avnguyen08/SSS_Motherboard/docs/3D-Model-7-11-25.pdf

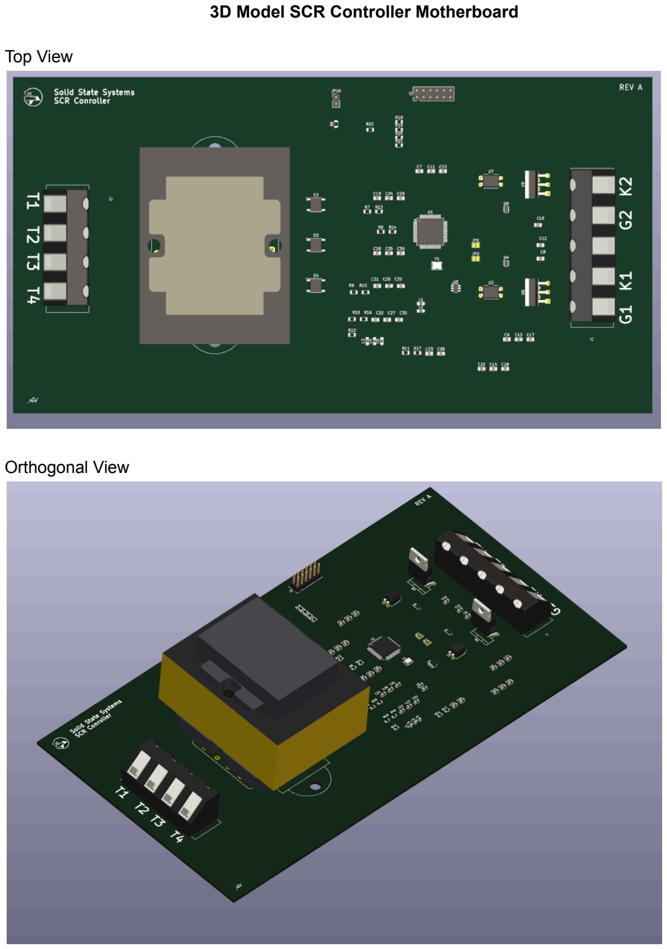
[picture p2: page 1]

3D Model SCR Controller Motherboard

Top View

Orthogonal View
