avnguyen08/SSS_Motherboard/hardware/SSS_Motherboard/MAX6817EUT_T.step

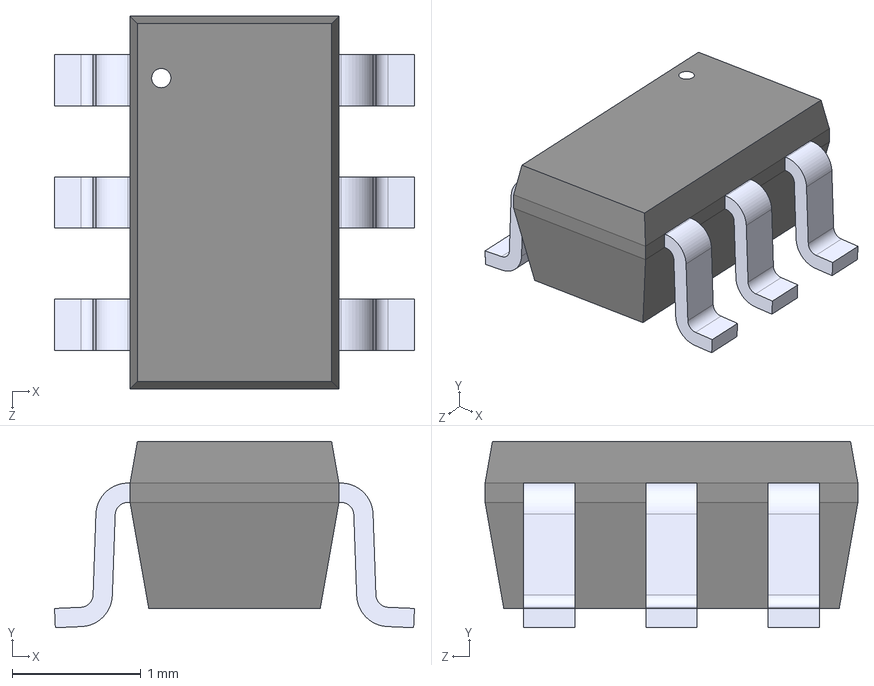
[picture p3: CAD file, 2025-07-15]
hardware/SSS_Motherboard/MAX6817EUT_T.step
2.80 x 1.45 x 2.90 mm
