avnguyen08/SSS_Motherboard/docs/Block_Diagram_6-Channel_SCR_PWM-5-21-25.pdf

6-Channel SCR Controller (PWM) | Date: 5/8/2025

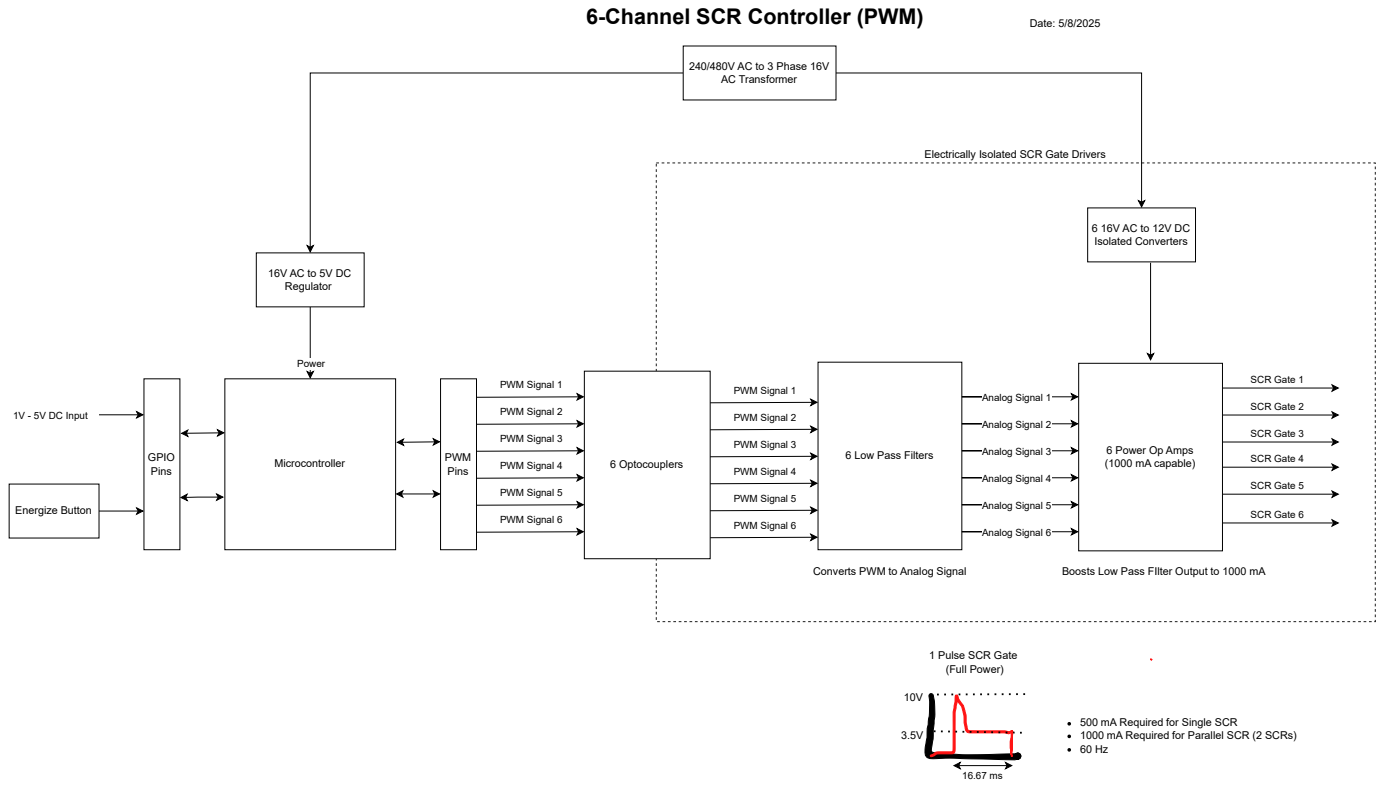
[picture p4: page 1]
Microcontroller; SCR Gate 1; SCR Gate 2; SCR Gate 3; SCR Gate 4; SCR Gate 5; SCR Gate 6; GPIO Pins; PWM Signal 1; 6 Optocouplers; Power; Energize Button; 1V - 5V DC Input; Analog Signal 1; Analog Signal 2; Analog Signal 3; Analog Signal 4; Analog Signal 5; Analog Signal 6; Converts PWM to Analog Signal; Boosts Low Pass FIlter Output to 1000 mA; PWM Pins; PWM Signal 2; PWM Signal 3; PWM Signal 4; PWM Signal 5; PWM Signal 6

240/480V AC to 3 Phase 16V
AC Transformer

Electrically Isolated SCR Gate Drivers

Isolated Converters

Regulator

6 Power Op Amps
(1000 mA capable)

6 Low Pass Filters

1 Pulse SCR Gate
(Full Power)

500 mA Required for Single SCR
1000 mA Required for Parallel SCR (2 SCRs)
