avnguyen08/SSS_Motherboard/docs/Schematic-7-11-25.pdf

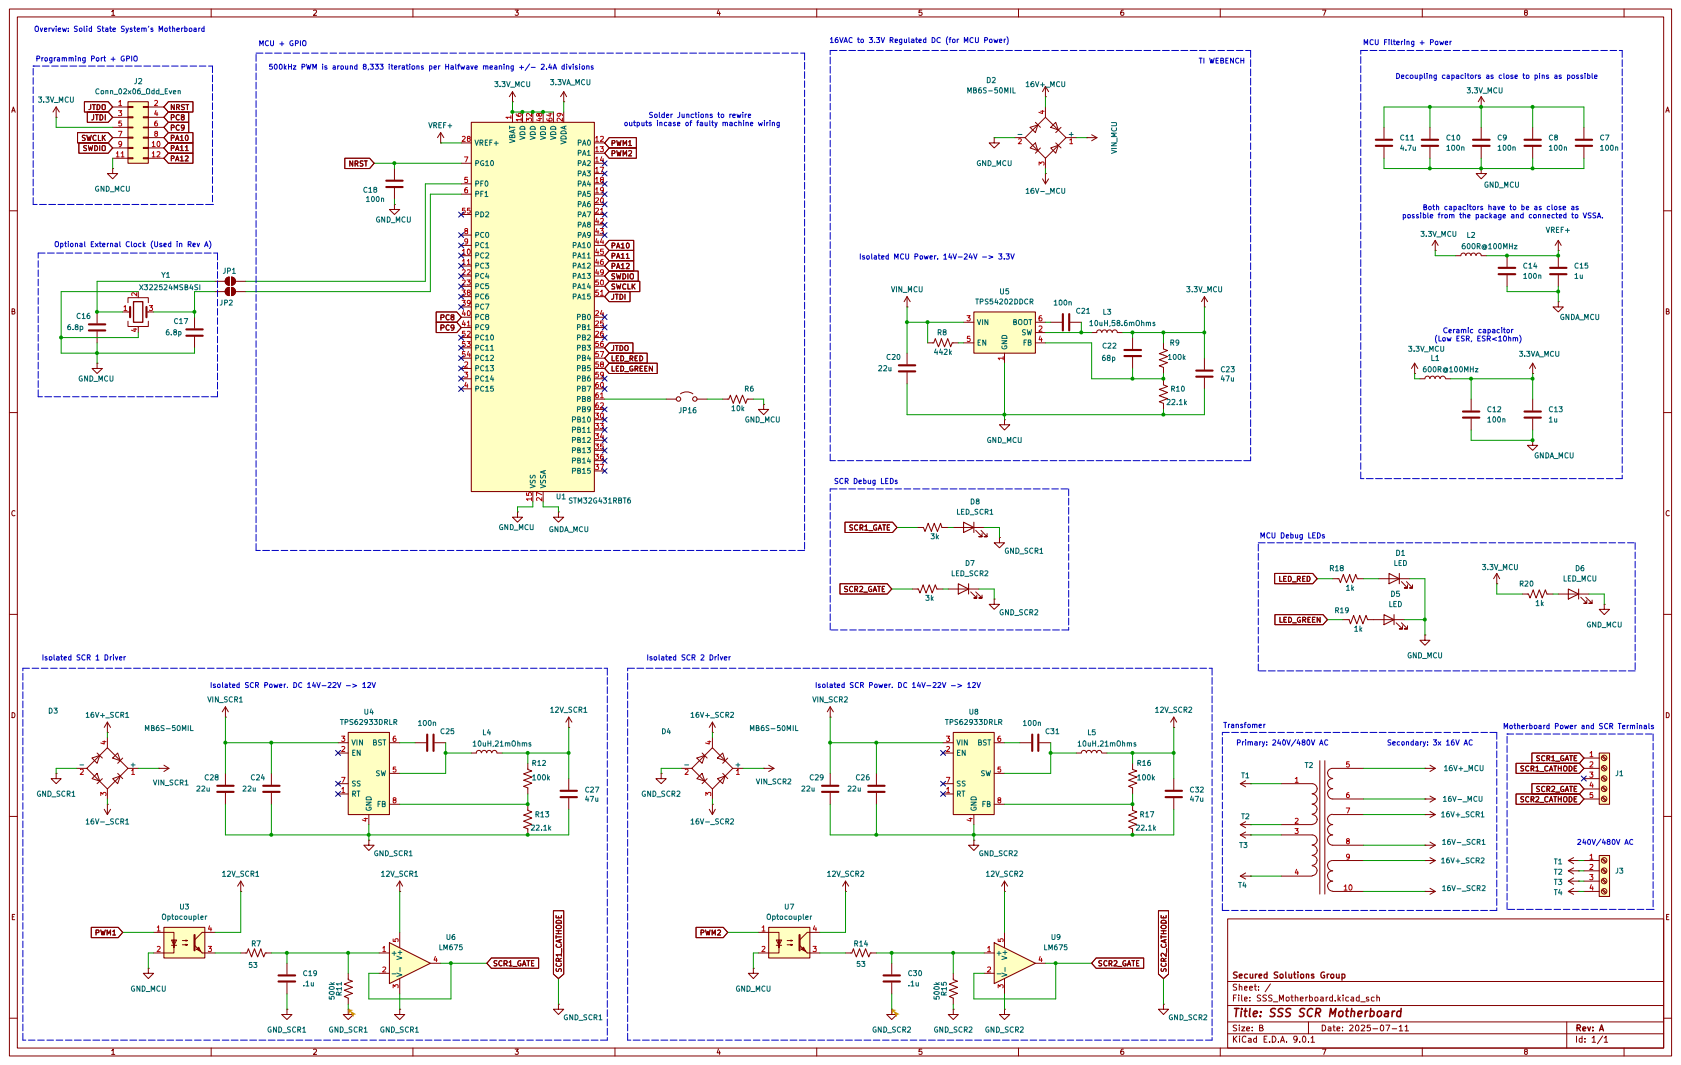
[picture p5: page 1]
