avnguyen08/SSS_Motherboard/hardware/Draft2.asc

C1: cap; .1µ
R1: res; 5
R2: res; 1Mega
R3: res; 1k
R4: res; 53
R5: res; 500k
U1: PC817A
V1: voltage; PULSE(0 3 0 10p 10p 1u 2u 20)
V2: voltage; 12; Rser=3m
Named nets: PWM, 0, COM, 12V, Vout, Filtered_PWM
.tran 50u
