avnguyen08/SSS_Motherboard/hardware/Draft3.asc

C1: cap; .01µ
R1: res; 5
R2: res; 1Mega
R3: res; 1k
R4: res; 500
R5: res; 500
U1: PC817A
U2: UniversalOpAmp
V1: voltage; PULSE(0 3 0 10n 10n 5u 10u 20)
V2: voltage; 12; Rser=3m
Named nets: PWM, 0, COM, 12V, Vout, Filtered_PWM
.tran 50u
