avnguyen08/SSS_Motherboard/hardware/Draft5.asc

R1: res; 1Mega
U2: UniversalOpAmp
V1: voltage; 12; Rser=3m
V2: voltage; SINE(2 1 100k)
Named nets: 12V, 0, COM
.tran 50u
