avnguyen08/SSS_Motherboard/hardware/PWM_Filter.asc

C1: cap; .1µ
Q1: npn; 2N2222
R1: res; 1k
R2: res; 50
R3: res; 100
R4: res; 1Mega
R5: res; 1k
R6: res; 53
U1: opamp
U2: PC817A
V1: voltage; PULSE(0 3 0 10p 10p 10u 20u 20)
V2: voltage; 12; Rser=3m
Named nets: PWM, 0, 12V, COM, Vout, INV_Vout, Filtered_PWM
.tran 500u
