avnguyen08/SSS_Motherboard/hardware/SCRSimulation.asc

R1: res; 100
U1: SCR; TN6050HP-12
V1: voltage; 20
V2: voltage; SINE(0 200 60)
Named nets: Wave, 0
.tran .1
.inc C:\\Users\\aaron\\OneDrive\\Documents\\LTspiceXVII\\lib\\sym\\st_high-temperature_scr_pspice\\st_high-temperature_scr.lib
