avnguyen08/SSS_Motherboard/hardware/Blue_Module.asc

C1: cap; 220µ
C2: cap; 4.7µ
D1: diode
D2: diode
D3: diode
D4: diode
D5: diode
D6: LED
D7: diode
Q1: npn
Q2: npn
Q3: npn
R1: res; 2.2
R2: res; 2.2
R3: res; 1k
R4: res; 100
R5: res; 40
R6: res; 470
R7: res; 4.7k
R8: res; 4.7k
R9: res; 4.7k
R10: res; 4.7k
R11: res; 4.7k
R12: res; 4.7k
R13: res; 100Mega
R14: res; 300
U1: PC817A
V1: voltage; SINE(0 16 60 0 0 0 10)
V2: voltage; PULSE(0 4 0 .0001 .0001 .008 .01666 10)
Named nets: 11, 10, 12, 14, 0, Input, Out, COM, before_input
.tran .6s
Blue Module (Input pulse converted into output across SCRs gate and cathode)
