avnguyen08/SSS_Motherboard/hardware/Draft4.asc

A1: and
A2: and
A3: and
A4: and
C1: cap
C2: cap
C3: cap
C4: cap
C5: cap
C6: cap
C7: cap
D1: diode
D2: diode
D3: diode
D4: diode
D5: diode
POT1: res
POT2: res
POT3: res
POT4: res
R1: res
R2: res
R3: res
R4: res
R5: res
R6: res
R7: res
R8: res
R9: res
R10: res
R11: res
R12: res
R13: res
R14: res
R15: res
R16: res
R17: res
R18: res
R19: res
R20: res
R21: res
R22: res
U1: opamp
U2: opamp
U3: opamp
U4: opamp
V1: voltage; SINE(0 14 60)
Named nets: 0, +, 10, 13, 2
.tran 100m
.inc opamp.sub
