avnguyen08/SSS_Motherboard/hardware/SSS_Motherboard/SSS_Motherboard.kicad_pcb

## KiCad design hardware/SSS_Motherboard/SSS_Motherboard.kicad_pcb (2025-09-15)

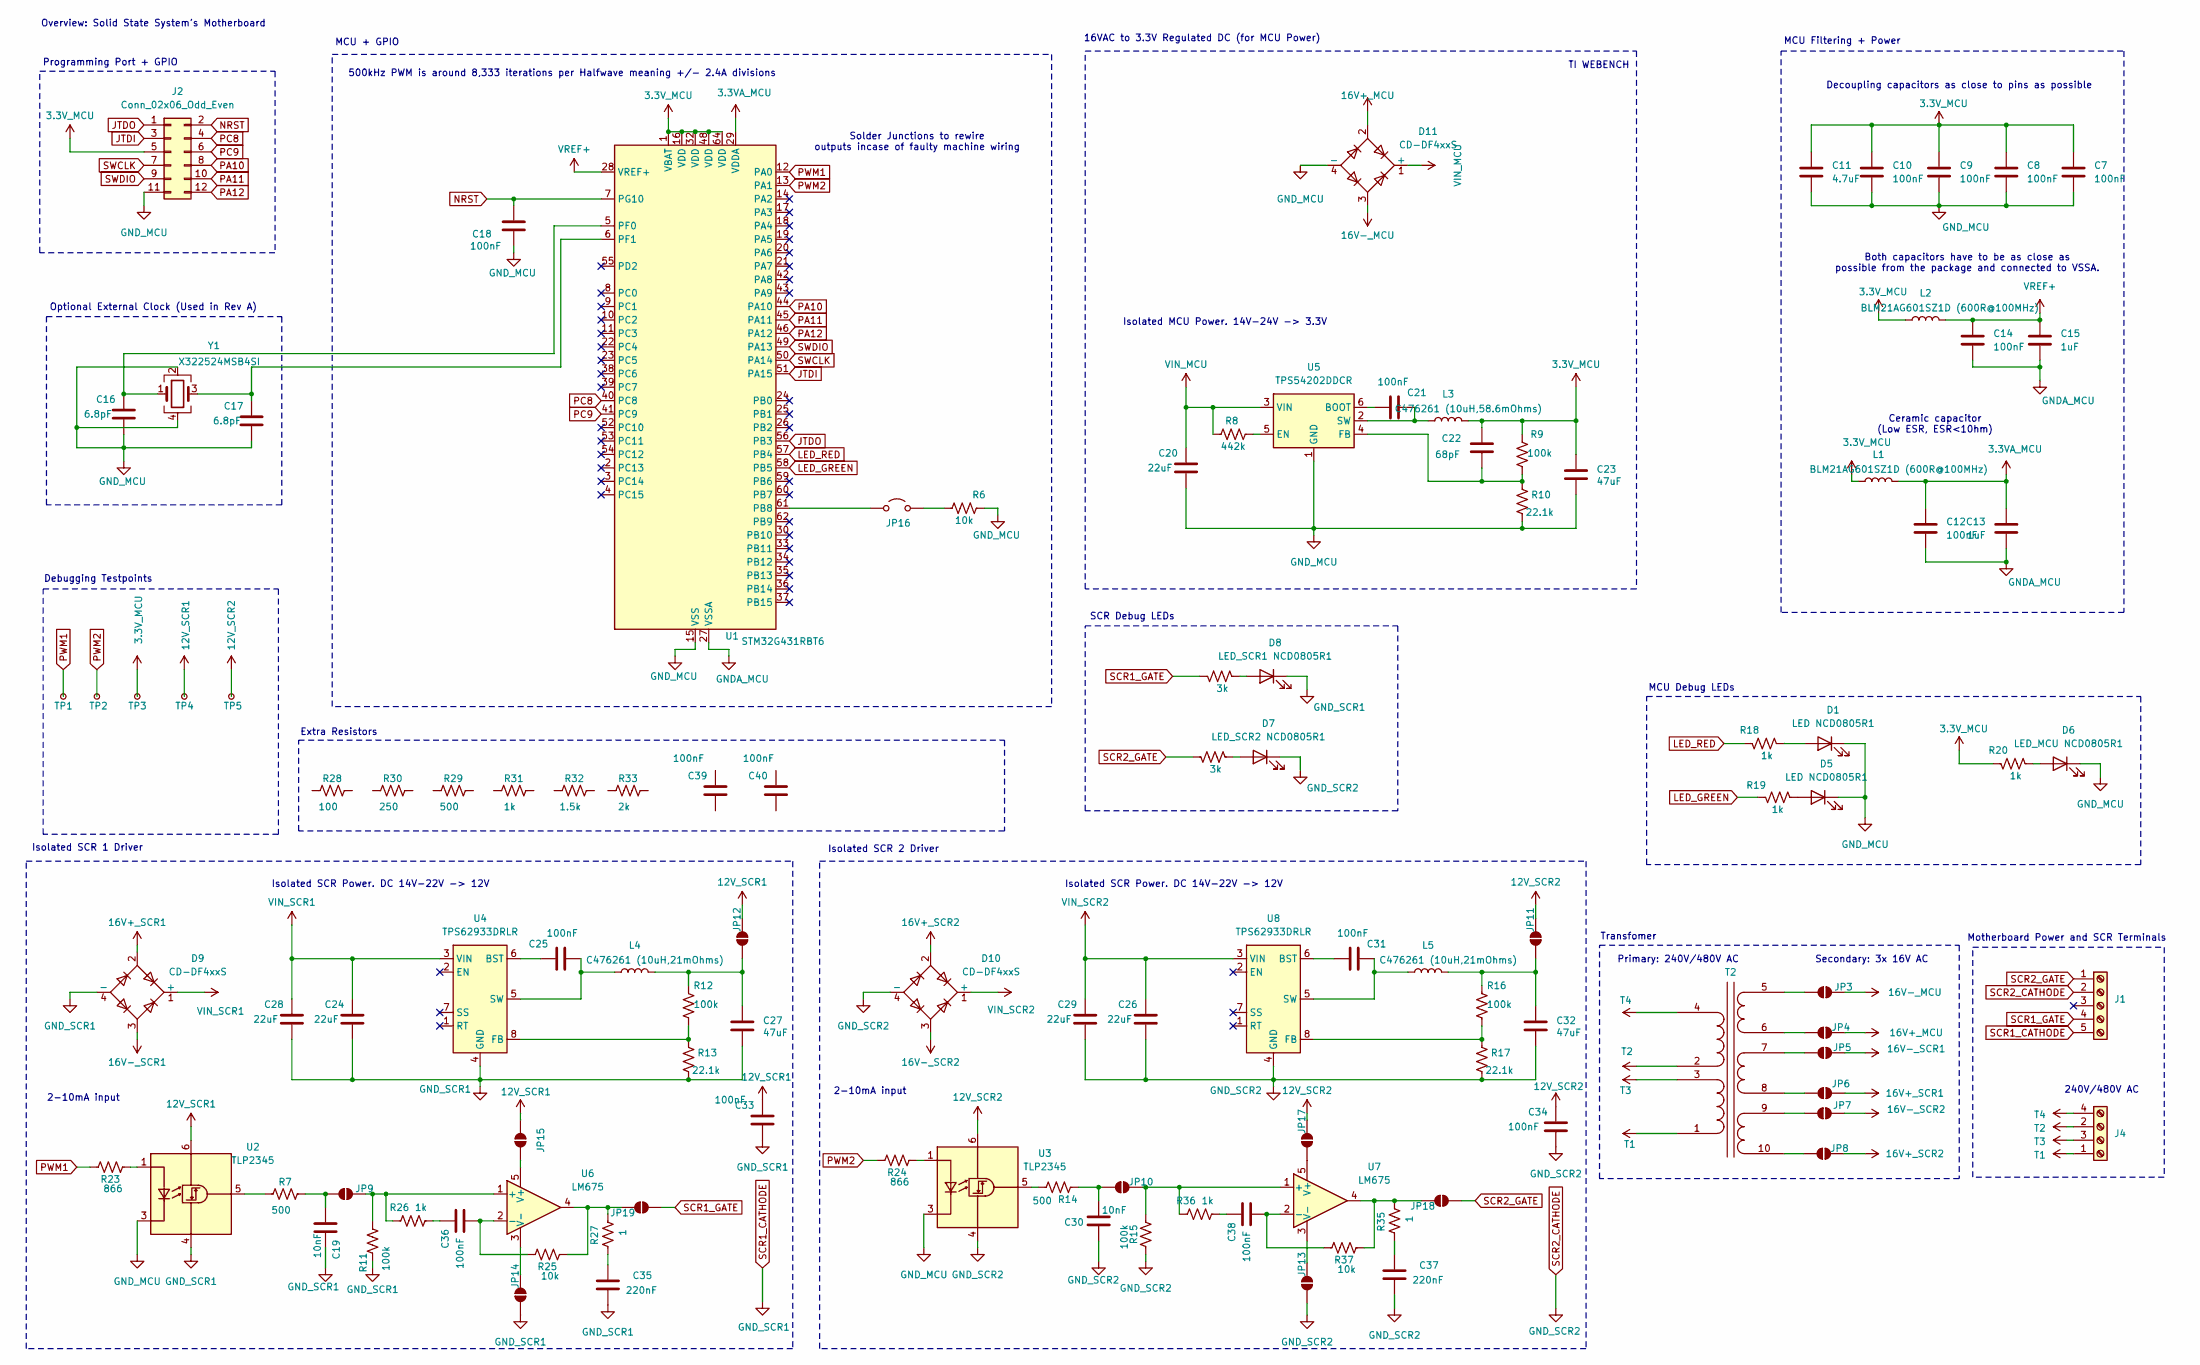
[picture p6: schematic SSS_Motherboard.kicad_sch, SSS SCR Motherboard]

Parts:
C7, C8, C9, C10, C12, C14, C18, C21, C25, C31, C33, C34, C36, C38, C39, C40: 100nF; C_0805_2012Metric
C11: 4.7uF; C_0805_2012Metric
C13, C15: 1uF; C_0805_2012Metric
C16, C17: 6.8pF; C_0805_2012Metric
C19, C30: 10nF; C_0805_2012Metric
C20, C24, C26, C28, C29: 22uF; C_0805_2012Metric
C22: 68pF; C_0805_2012Metric
C23, C27, C32: 47uF; C_0805_2012Metric
C35, C37: 220nF; C_0805_2012Metric
D1, D5: LED NCD0805R1; D_0805_2012Metric
D6: LED_MCU NCD0805R1; D_0805_2012Metric
D7: LED_SCR2 NCD0805R1; D_0805_2012Metric
D8: LED_SCR1 NCD0805R1; D_0805_2012Metric
D9, D10, D11: CD-DF4xxS; CD-DF4xxS(L)
J1: Screw_Terminal_01x05; 5_Connector_11.13_Pitch
J2: Conn_02x06_Odd_Even; PinHeader_2x06_P2.54mm_Vertical
J4: Screw_Terminal_01x04; 4_Connector_11.13_Pitch
JP3, JP4, JP5, JP6, JP7, JP8, JP9, JP10, JP11, JP12, JP13, JP14, JP15, JP17, JP18, JP19: SolderJumper_2_Open; SolderJumper-2_P1.3mm_Open_Pad1.0x1.5mm
JP16: Jumper_2_Open; PinHeader_1x02_P2.54mm_Vertical
L1, L2: BLM21AG601SZ1D (600R@100MHz); L_0805_2012Metric
L3: C476261 (10uH,58.6mOhms); SRN6045
L4, L5: C476261 (10uH,21mOhms); SRN6045
R6, R25, R37: 10k; R_0805_2012Metric
R7, R14, R29: 500; R_0805_2012Metric
R8: 442k; R_0805_2012Metric
R9, R11, R12, R15, R16: 100k; R_0805_2012Metric
R10, R13, R17: 22.1k; R_0805_2012Metric
R18, R19, R20, R26, R31, R36: 1k; R_0805_2012Metric
R21, R22: 3k; R_0805_2012Metric
R23, R24: 866; R_0805_2012Metric
R27, R35: 1; R_0805_2012Metric
R28: 100; R_0805_2012Metric
R30: 250; R_0805_2012Metric
R32: 1.5k; R_0805_2012Metric
R33: 2k; R_0805_2012Metric
T2: Transformer_2P_3S; Transformer
TP1, TP2, TP3, TP4, TP5: TestPoint_Small; TestPoint_Loop_D2.50mm_Drill1.0mm
U1: STM32G431RBT6; LQFP-64_10x10mm_P0.5mm
U2, U3: TLP2345; SO-5-6_4.55x3.7mm_P1.27mm
U4, U8: TPS62933DRLR; SOT-583-8
U5: TPS54202DDCR; SOT-23-6
U6, U7: LM675; TO-220-5_P3.4x3.7mm_StaggerOdd_Lead3.8mm_Vertical
Y1: X322524MSB4SI; Crystal_SMD_3225-4Pin_3.2x2.5mm

Connections:
3.3VA_MCU: C12.1, C13.1, L1.1, U1.29 (VDDA)
3.3V_MCU: C7.1, C8.1, C9.1, C10.1, C11.1, C22.2, C23.1, J2.5, L1.2, L2.1, L3.1, R9.1, R20.1, TP3.1, U1.1 (VBAT), U1.16 (VDD), U1.32 (VDD), U1.48 (VDD), U1.64 (VDD)
12V_SCR1: C33.1, JP12.2 (B), JP15.2 (B), TP4.1, U2.6 (VDD)
12V_SCR2: C34.1, JP11.2 (B), JP17.2 (B), TP5.1, U3.6 (VDD)
16V+_MCU: D11.2, JP4.2 (B)
16V+_SCR1: D9.2, JP6.2 (B)
16V+_SCR2: D10.2, JP8.2 (B)
16V-_MCU: D11.3, JP3.2 (B)
16V-_SCR1: D9.3, JP5.2 (B)
16V-_SCR2: D10.3, JP7.2 (B)
GNDA_MCU: C12.2, C13.2, C14.2, C15.2, U1.27 (VSSA)
GND_MCU: C7.2, C8.2, C9.2, C10.2, C11.2, C16.2, C17.2, C18.1, C20.2, C23.2, D1.1 (K), D5.1 (K), D6.1 (K), D11.4 (-), J2.11, R6.1, R10.1, U1.15 (VSS), U1.31 (VSS), U1.47 (VSS), U1.63 (VSS), U2.3 (K), U3.3 (K), U5.1 (GND), Y1.2, Y1.4
JTDI: J2.3, U1.51 (PA15)
JTDO: J2.1, U1.56 (PB3)
LED_GREEN: R19.1, U1.58 (PB5)
LED_RED: R18.1, U1.57 (PB4)
NRST: C18.2, J2.2, U1.7 (PG10)
unnamed: C35.1, R27.2
unnamed: C36.1, R26.1
unnamed: C37.1, R35.2
unnamed: C38.1, R36.1
unnamed: D1.2 (A), R18.2
unnamed: D5.2 (A), R19.2
unnamed: D6.2 (A), R20.2
unnamed: D7.2 (A), R21.2
unnamed: D8.2 (A), R22.2
unnamed: JP3.1 (A), T2.5 (SA)
unnamed: JP4.1 (A), T2.6 (SB)
unnamed: JP5.1 (A), T2.7 (SC)
unnamed: JP6.1 (A), T2.8 (SD)
unnamed: JP7.1 (A), T2.9 (SC)
unnamed: JP8.1 (A), T2.10 (SD)
unnamed: C19.1, JP9.1 (A), R7.2
unnamed: JP9.2 (B), R11.2, R26.2, U6.1 (+)
unnamed: C30.1, JP10.1 (A), R14.2
unnamed: JP10.2 (B), R15.2, R36.2, U7.1 (+)
unnamed: C32.1, JP11.1 (A), L5.1, R16.1
unnamed: C27.1, JP12.1 (A), L4.1, R12.1
unnamed: JP13.2 (B), U7.3 (V-)
unnamed: JP14.2 (B), U6.3 (V-)
unnamed: JP15.1 (A), U6.5 (V+)
unnamed: JP16.1 (A), U1.61 (PB8)
unnamed: JP16.2 (B), R6.2
unnamed: JP17.1 (A), U7.5 (V+)
unnamed: JP18.2 (B), R35.1, R37.1, U7.4
unnamed: JP19.2 (B), R25.1, R27.1, U6.4
unnamed: C16.1, U1.5 (PF0), Y1.1
unnamed: C17.1, U1.6 (PF1), Y1.3
unnamed: R23.1, U2.1 (A)
unnamed: R7.1, U2.5 (VO)
unnamed: R24.1, U3.1 (A)
unnamed: R14.1, U3.5 (VO)
unnamed: C25.1, U4.6 (BST)
unnamed: R12.2, R13.2, U4.8 (FB)
unnamed: C25.2, L4.2, U4.5 (SW)
unnamed: C21.2, U5.6 (BOOT)
unnamed: R8.1, U5.5 (EN)
unnamed: C22.1, R9.2, R10.2, U5.4 (FB)
unnamed: C21.1, L3.2, U5.2 (SW)
unnamed: C36.2, R25.2, U6.2 (-)
unnamed: C38.2, R37.2, U7.2 (-)
unnamed: C31.2, U8.6 (BST)
unnamed: R16.2, R17.2, U8.8 (FB)
unnamed: C31.1, L5.2, U8.5 (SW)
PA10: J2.8, U1.44 (PA10)
PA11: J2.10, U1.45 (PA11)
PA12: J2.12, U1.46 (PA12)
PC8: J2.4, U1.40 (PC8)
PC9: J2.6, U1.41 (PC9)
PWM1: R23.2, TP1.1, U1.12 (PA0)
PWM2: R24.2, TP2.1, U1.13 (PA1)
SCR1_CATHODE: C19.2, C24.2, C27.2, C28.2, C33.2, C35.2, D8.1 (K), D9.4 (-), J1.5, JP14.1 (A), R11.1, R13.1, U2.4 (GND), U4.4 (GND)
SCR1_GATE: J1.4, JP19.1 (A), R22.1
SCR2_CATHODE: C26.2, C29.2, C30.2, C32.2, C34.2, C37.2, D7.1 (K), D10.4 (-), J1.2, JP13.1 (A), R15.1, R17.1, U3.4 (GND), U8.4 (GND)
SCR2_GATE: J1.1, JP18.1 (A), R21.1
SWCLK: J2.7, U1.50 (PA14)
SWDIO: J2.9, U1.49 (PA13)
T1: J4.1 (Pin_4), T2.1 (AA)
T2: J4.2, T2.2 (AA)
T3: J4.3, T2.3 (AB)
T4: J4.4 (Pin_1), T2.4 (AB)
VIN_MCU: C20.1, D11.1 (+), R8.2, U5.3 (VIN)
VIN_SCR1: C24.1, C28.1, D9.1 (+), U4.3 (VIN)
VIN_SCR2: C26.1, C29.1, D10.1 (+), U8.3 (VIN)
VREF+: C14.1, C15.1, L2.2, U1.28 (VREF+)

Notes on the sheet:
Secondary: 3x 16V AC
Isolated SCR Power. DC 14V-22V -> 12V
Motherboard Power and SCR Terminals
Isolated SCR 2 Driver
MCU + GPIO
Isolated SCR 1 Driver
Decoupling capacitors as close to pins as possible
Primary: 240V/480V AC
Optional External Clock (Used in Rev A)
Transfomer
SCR Debug LEDs
2-10mA input
Solder Junctions to rewire outputs incase of faulty machine wiring
Debugging Testpoints
500kHz PWM is around 8,333 iterations per Halfwave meaning +/- 2.4A divisions
MCU Filtering + Power
Isolated MCU Power. 14V-24V -> 3.3V
Both capacitors have to be as close as possible from the package and connected to VSSA.
TI WEBENCH
Ceramic capacitor (Low ESR, ESR<10hm)
Extra Resistors
Programming Port + GPIO
MCU Debug LEDs
240V/480V AC
Overview: Solid State System's Motherboard
16VAC to 3.3V Regulated DC (for MCU Power)

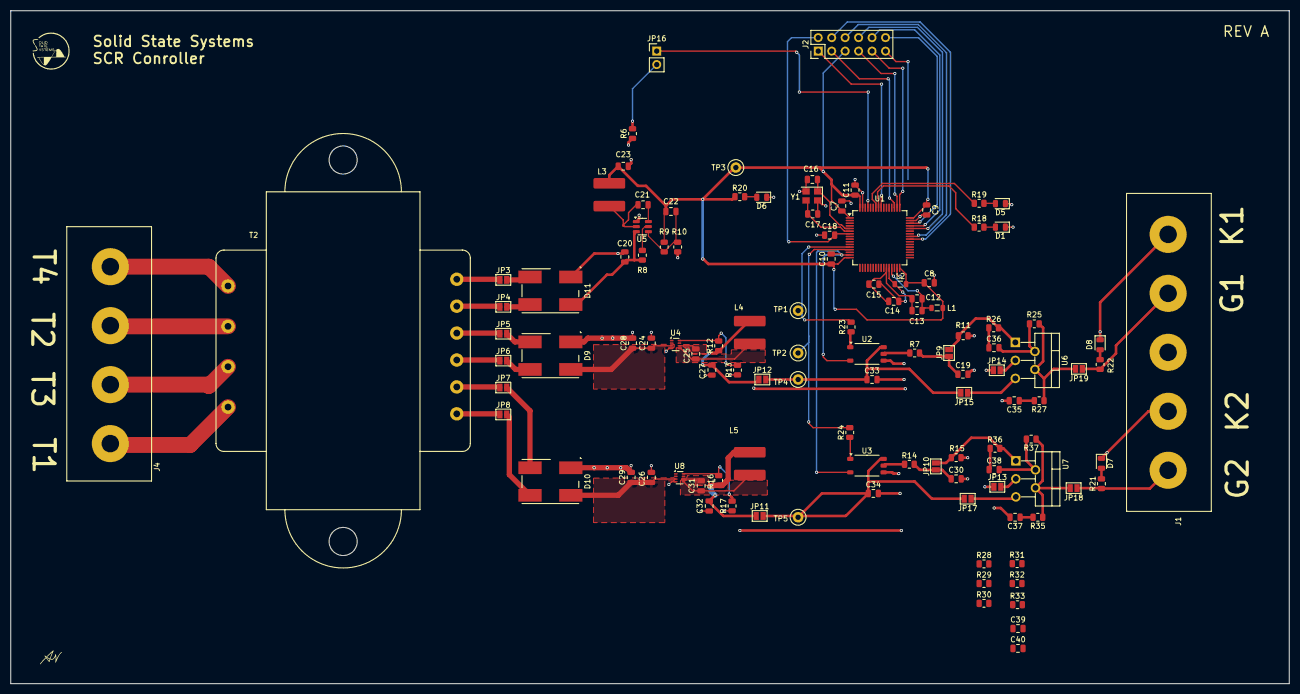
[picture p7: board SSS_Motherboard.kicad_pcb from above]

Board: 2 copper layers, 241.3 x 127.0 mm, 113 parts (0 on the bottom side), 85 nets.
