avnguyen08/SSS_Motherboard/software/workspace_1.18.1/SSS_Motherboard/SSS_Motherboard.ioc

Mcu.UserName=STM32G431RBTx
PA0.Signal=S_TIM2_CH1
PA1.Signal=S_TIM2_CH2
PB4.GPIO_Label=LED_RED
PB4.Signal=GPIO_Output
PB5.GPIO_Label=LED_GREEN
PB5.Signal=GPIO_Output
PF0-OSC_IN.Signal=RCC_OSC_IN
PF1-OSC_OUT.Signal=RCC_OSC_OUT
