avnguyen08/SSS_Motherboard/software/workspace_1.18.1/SSS_Motherboard/Core/Inc/main.h

#define LED_RED_Pin GPIO_PIN_4
#define LED_RED_GPIO_Port GPIOB
#define LED_GREEN_Pin GPIO_PIN_5
#define LED_GREEN_GPIO_Port GPIOB
