avnguyen08/SSS_Motherboard/(commit log)

2025-05-31 Mother board project git start
2025-07-15 approved schematic
    [MAX6817EUT_T.step, SSS_Motherboard.kicad_pcb, SSS_Motherboard.kicad_sch, bom.csv, designators.csv, positions.csv]
2025-09-15 manufacturing batch
    [SSS_Motherboard.kicad_pcb, SSS_Motherboard.kicad_sch, bom.csv, designators.csv, positions.csv]
