avnguyen08/SSS_Motherboard/(notices)

Notices in the files:
software/workspace_1.18.1/SSS_Motherboard/Core/Inc/main.h:
Copyright (c) 2025 STMicroelectronics.
All rights reserved.
This software is licensed under terms that can be found in the LICENSE file
